rbwhipple/VRA-FS/WSAB Schematic.bmp

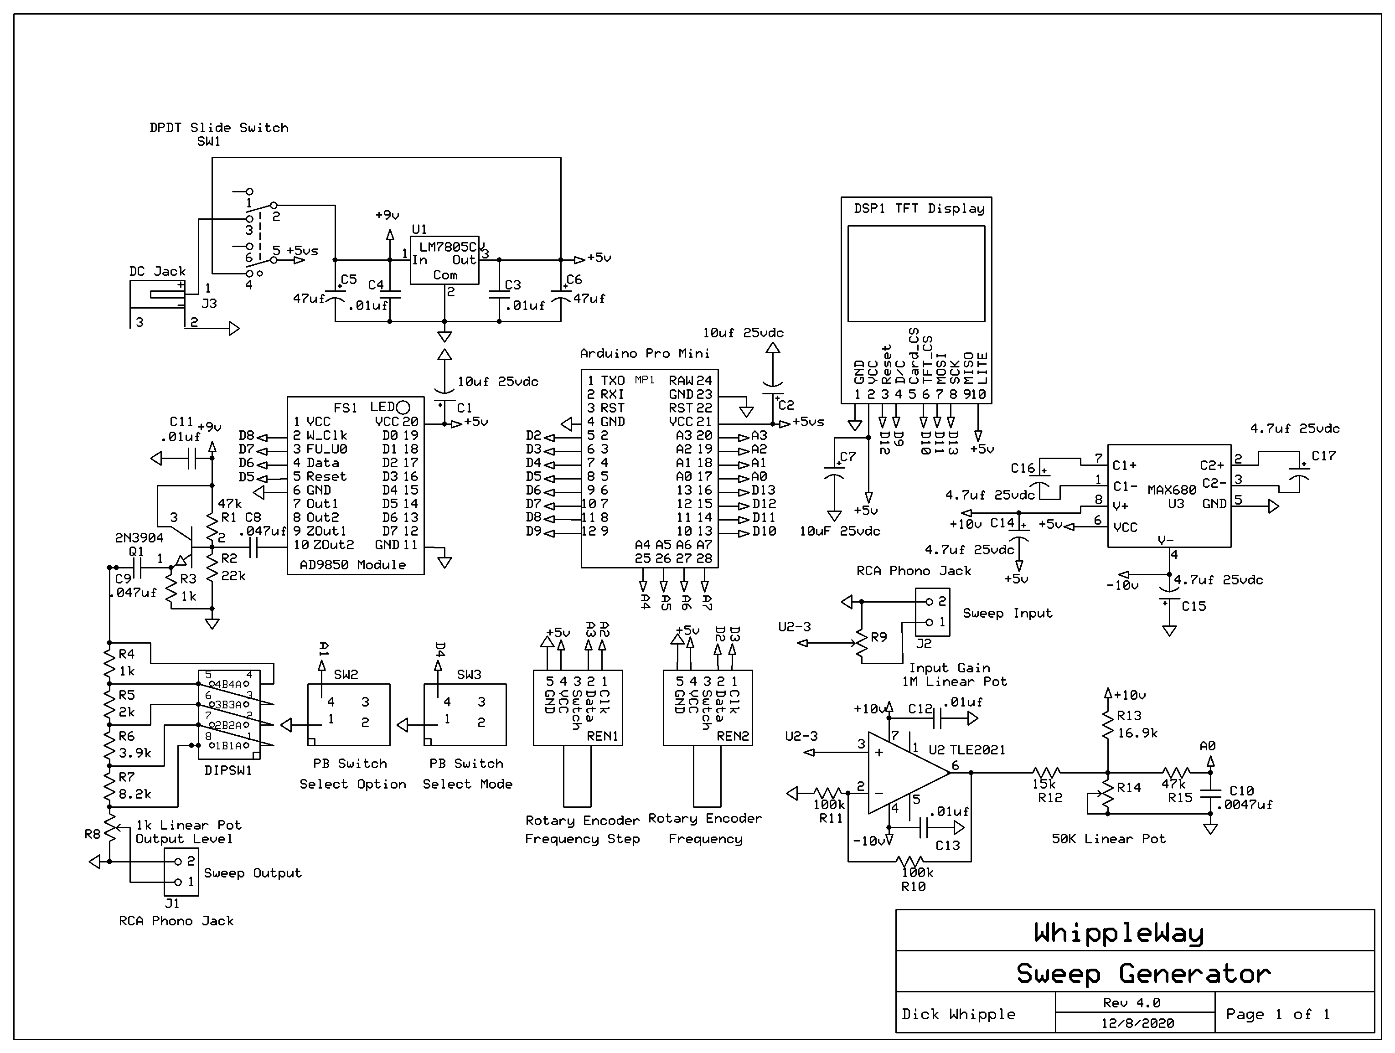
WSAB Schematic.bmp
