rbwhipple/VRA-FS/(list of files, drawings)

Other design files:
WSAB_PCB_Ver_1.pcb
