rbwhipple/VRA-FS/(threads)

Thread 1 (2022-07-02):

ExpressPCB

eburman, 2022-07-02:
ExpressPCB service is inaccessible for many people who don't have PC computers. ExpressPCB uses a proprietary service that excludes MAC PC users. Gerber files are universal and can be used by most PCB fabricators. Would you please post the Gerber files?

rbwhipple, 2022-07-02:
Thanks for the heads up. I didn’t know. I can request Gerber files when ordering a board but may not be able to get one otherwise. I will try and post the result.

eburman, 2022-07-02:
Thanks Dick. I suppose I could just do point to point wiring on a perf board but I’ve already gotten all the parts on your list which are designed to go onto the PCB so that would be my best option.

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

rbwhipple, 2022-07-02:
Since it is holiday weekend, I doubt I can get anything accomplished until next week. Enjoy the 4th!

rbwhipple, 2022-07-19:
Mr. Burman,

I heard back from ExpressPCB and sent you a return email last week.  Guess it didn’t make it. This time please reply to let me know you receive it.

ExpressPCB suggested I use the Export feature of their “Plus” software to produce a file suitable for non-PC users.  The attached file was what was produced by their Export function, but I am not acquainted with the file type. Maybe it means something to you.  Let me know if it works for you and, if it does, I will update by WEB resources at N&V.

Thanks,

Dick

Dick  Whipple

 ***@***.***> ***@***.***

(830) 275-3456

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

eburman, 2022-07-19:
Hello Dick. For some reason or another I'm just not consistently getting your replies in my email box through Github.  Maybe you could just email me directly? My email is: eskburman@suddenlink.net. I don't see an attached file here on Github so maybe you could send it directly to my email? I'll try to figure it out and I'll let you know if it works through another PCB fabricator. Thank you so much for working through this with me. I think it's a great project and I'm learning a lot from your book and the article in N&V's.

eburman, 2022-07-19:
Hello Dick:
I had somehow accidentally deleted your message but I went back and found it. The file you exported isn’t attached. So you may need to email outside of Github, it seems that the Github site didn’t allow you to attach a file or something like that.
Erik.

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

Mountaincat69, 2025-03-28:
Hi All, FYI ExpressPCB advertises that they include gerber files with every order.

Thread 2 (2022-07-24):

Display Flicker

b-forsberg, 2022-07-24:
First of all nice job with this project. I just finished putting mine together and am currently testing. The text portions at the top and bottom of the display are flickering with the bottom of the display the worse. I just want to ask if this is expected behavior or do I have a problem? I assume this is just the display being redrawn. Thanks for your time.

rbwhipple, 2022-07-24:
Yes, the behavior is normal.  I erase and redisplay everything each scan. I suppose a clever programmer could handle it better, but it is what it is.  Dick

Dick  Whipple

 ***@***.***> ***@***.***

(830) 275-3456

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

b-forsberg, 2022-07-24:
Thanks for the reply. OK looks my device is now working. I have modified the code to update the header only when data changes. I will looked at the footer another time but its data is changing most of the time.

Closed 2022-07-24.

Thread 3 (2023-08-20):

TFT Display from Amazon does not match the one in project

peterbuxton, 2023-08-20:
Mr. Whipple:

I bought your book, _Vintage Radio Alignment From Scratch_, and it is a wonderful reference. I also enthusiastically began to build your alignment instrument and bought all the parts on the list. You specify the **DSD TECH 1.8 Inch TFT LCD from Amazon**. On Amazon I found one with [exactly that title](https://www.amazon.com/DSD-TECH-Display-Interface-Arduino/dp/B07WDJ3TV6) but it turned out to be 11 pins with completely different labels than the 10-pin display in the schematic. In fact, I can't even find a 10-pin LCD that matches the title or schematic pinout.

The display I ordered from Amazon uses SPI communication but your Arduino code doesn't indicate that (or even which protocol is used). Is there a way to make the SPI display from Amazon work in your Arduino code or is there a different display available that matches your code? Thank you.

Peter Buxton

b-forsberg, 2023-08-20:
Peter, my name is Bruce and I have successfully built Mr. Whipple's device.
I used the Adafruit 358 display. I got mine at Mouser at:
https://www.mouser.com/ProductDetail/485-358

The Adafruit 358 is available elsewhere as well.
Good Luck building your device.

Bruce Forsberg

On Sun, Aug 20, 2023 at 9:21 AM Peter Buxton ***@***.***>
wrote:

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

peterbuxton, 2023-08-20:
Hello Bruce,

Thank you so much for this information!

Peter

peterbuxton, 2023-08-21:
I just wanted to leave a note saying that with Bruce Forsberg's information, I was able to find information on the Internet to translate the Adafruit 358 display's pin functions to my DSD display's pins to make it work in a test circuit, so now I should be able to use it with Mr. Whipple's code.

Closed 2023-08-21.
